Jack-SparrowQ/Teslaneitor/electronics/bom.csv

componente | cantidad | estado | funcion | coste_aprox_usd | certeza | notas
Arduino Uno R3 CH340 | 1 | incluido | control y maquina de estados | 0 | KIT | alimentado por VIN desde la bateria (H3)
Controlador L298N | 1 | incluido | driver de motores | 0 | KIT | anadir pull-down 10k en ENA/ENB; datasheet B8 pendiente
Motorreductor 1:48 doble eje | 2 | incluido | traccion | 0 | KIT | tension y rpm sin verificar (T2)
Rueda 65x25 mm | 2 | incluido | traccion | 0 | KIT
Rueda loca | 1 | incluido | apoyo | 0 | KIT
Sensor ultrasonico HC-SR04 | 1 | incluido | distancia frontal | 0 | KIT | objeto >= 0.5 m2 (B5)
Sensor TCRT5000 | 2 | incluido | no usado en v1 | 0 | KIT
Modulo Bluetooth HC-06/BT-04 | 1 | incluido | no usado en v1 | 0 | KIT
Chasis acrilico + tornilleria | 1 | incluido | estructura | 0 | KIT | pala de sumo desmontada
Portapilas 6xAA | 1 | incluido | alimentacion | 0 | KIT
ESP32-CAM AI-Thinker (OV2640) | 1 | propuesto | foto + SD + NTP + log | 6-10 | VERIFICAR
Programador ESP32-CAM-MB (USB) | 1 | propuesto | programar ESP32-CAM | 3-5 | VERIFICAR | a veces viene junto con la ESP32-CAM
Tarjeta microSD 4-8 GB FAT32 | 1 | propuesto | fotos y log | 4-8 | VERIFICAR | especificacion: max 4 GB (B6; H5)
Adaptador de nivel bidireccional BSS138 4 canales | 1 | propuesto | UART 5V <-> 3.3V | 1-2 | VERIFICAR | sustituye al divisor (H1)
Convertidor buck a 5 V (p. ej. MP1584) | 1 | propuesto | alimentacion ESP32-CAM | 1-3 | VERIFICAR | ajustar a 5.0 V con multimetro antes de conectar
Condensador electrolitico 470 uF 16 V | 1 | propuesto | desacoplo ESP32-CAM | 0.2 | VERIFICAR
Condensador ceramico 100 nF | 3 | propuesto | desacoplo y filtro A0 | 0.1 | VERIFICAR
Resistencias 10k (x2) y 100k (x1) | 1 surtido | propuesto | pull-down ENA/ENB y divisor de bateria | 1-3 | VERIFICAR
Pulsador | 1 | propuesto | boton de inicio / rearme | 0.2 | VERIFICAR
Interruptor de palanca | 1 | propuesto | parada de emergencia | 0.5-1 | VERIFICAR | solo si el kit no trae
Pilas AA NiMH + cargador | 6 | propuesto | alimentacion | 10-20 | VERIFICAR | solo si no las tienes
