Jack-SparrowQ/Teslaneitor/electronics/kicad/teslaneitor.pdf

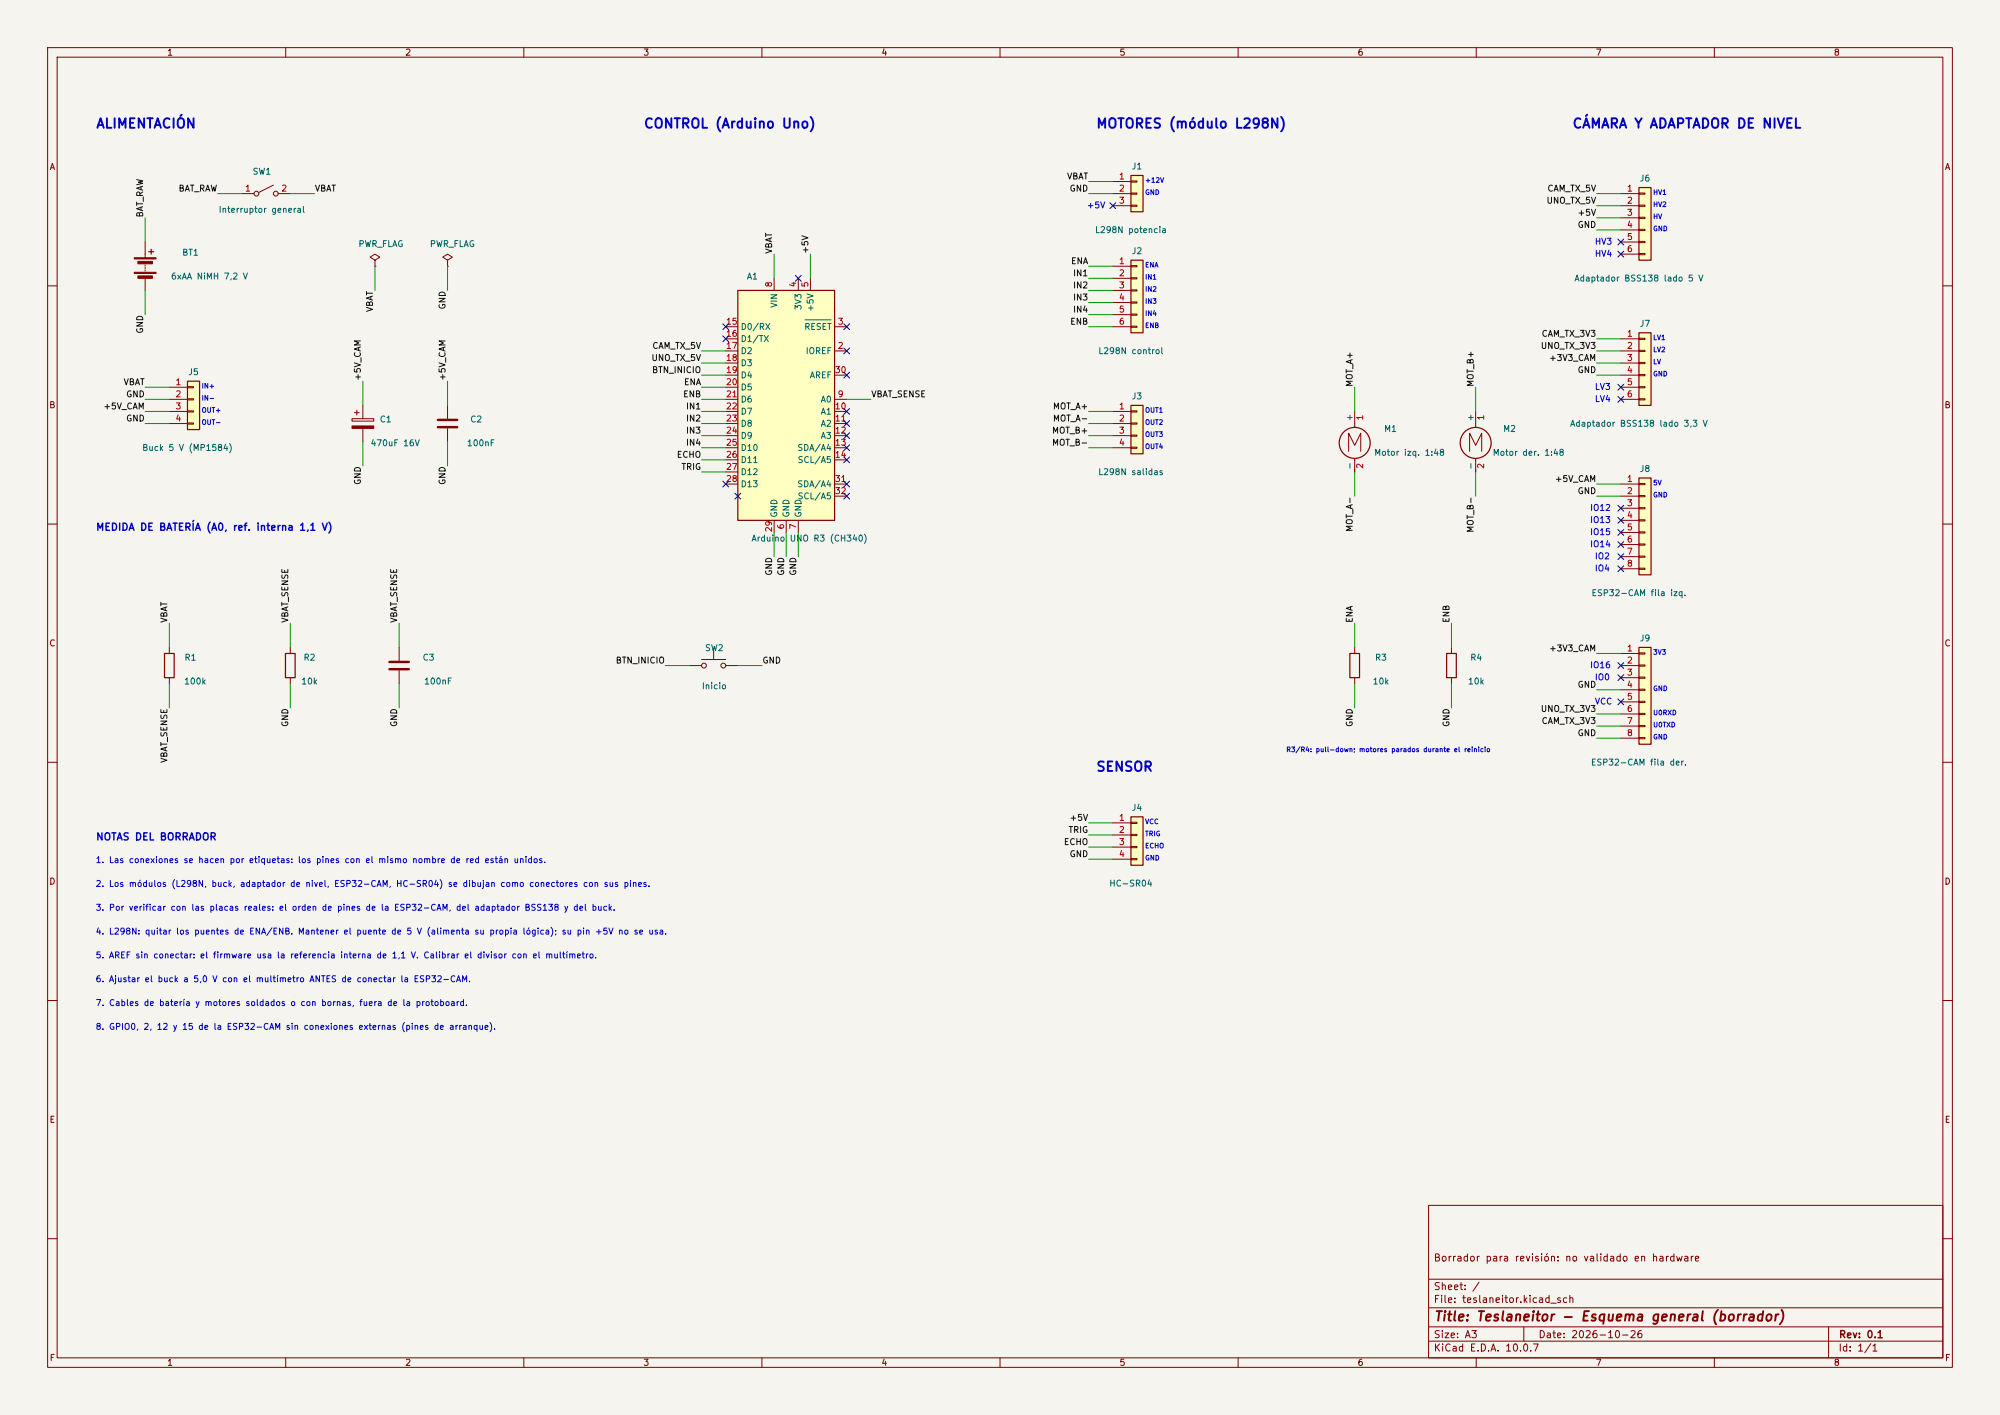
[picture p3: page 1]

GND CÁMARA Y ADAPTADOR DE NIVEL

1. Las conexiones se hacen por etiquetas: los pines con el mismo nombre de red están unidos. 6. Ajustar el buck a 5,0 V con el multímetro ANTES de conectar la ESP32-CAM.

7. Cables de batería y motores soldados o con bornas, fuera de la protoboard. 2. Los módulos (L298N, buck, adaptador de nivel, ESP32-CAM, HC-SR04) se dibujan como conectores con sus pines.

4. L298N: quitar los puentes de ENA/ENB. Mantener el puente de 5 V (alimenta su propia lógica); su pin +5V no se usa.

Borrador para revisión: no validado en hardware

Sheet: /
File: teslaneitor.kicad_sch
Title: Teslaneitor - Esquema general (borrador)

Size: A3 | Rev: 0.1 | F Date: 2026-10-26
KiCad E.D.A. 10.0.7 | Id: 1/1
