Jack-SparrowQ/Teslaneitor/electronics/kicad/teslaneitor.kicad_sch

## KiCad design electronics/kicad/teslaneitor.kicad_sch (2026-10-27)

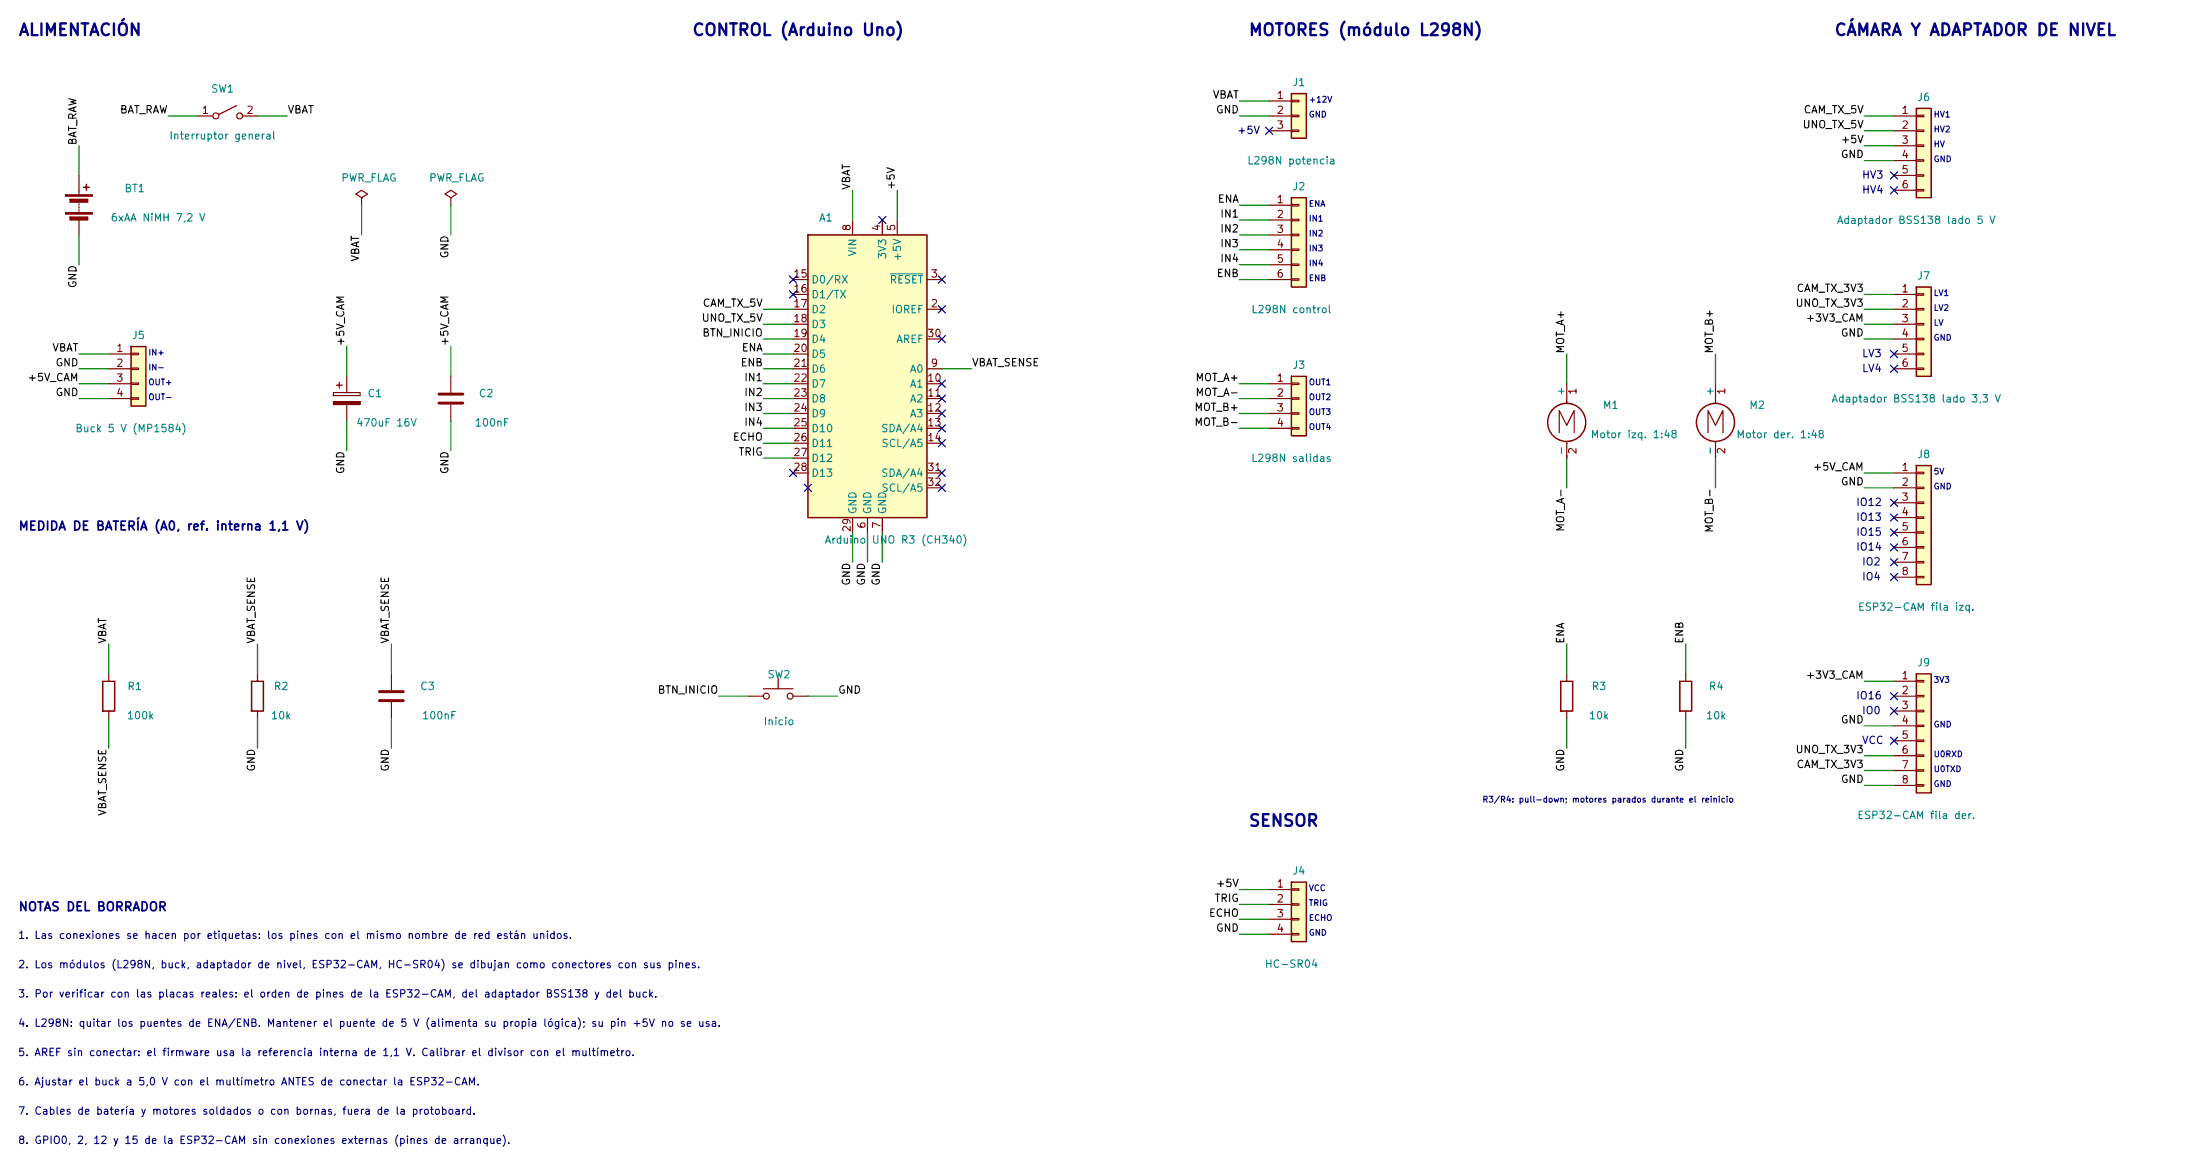
[picture p4: schematic teslaneitor.kicad_sch]

Parts:
A1: Arduino UNO R3 (CH340)
BT1: 6xAA NiMH 7,2 V
C1: 470uF 16V
C2, C3: 100nF
J1: L298N potencia
J2: L298N control
J3: L298N salidas
J4: HC-SR04
J5: Buck 5 V (MP1584)
J6: Adaptador BSS138 lado 5 V
J7: Adaptador BSS138 lado 3,3 V
J8: ESP32-CAM fila izq.
J9: ESP32-CAM fila der.
M1: Motor izq. 1:48
M2: Motor der. 1:48
R1: 100k
R2, R3, R4: 10k
SW1: Interruptor general
SW2: Inicio

Connections:
+3V3_CAM: J7.3, J9.1
+5V: A1.5 (+5V), J4.1, J6.3
+5V_CAM: C1.1, C2.1, J5.3, J8.1
BAT_RAW: BT1.1 (+), SW1.1 (A)
BTN_INICIO: A1.19 (D4), SW2.1
CAM_TX_3V3: J7.1, J9.7
CAM_TX_5V: A1.17 (D2), J6.1
ECHO: A1.26 (D11), J4.3
ENA: A1.20 (D5), J2.1, R3.1
ENB: A1.21 (D6), J2.6, R4.1
GND: A1.6 (GND), A1.7 (GND), A1.29 (GND), BT1.2 (-), C1.2, C2.2, C3.2, J1.2, J4.4, J5.2, J5.4, J6.4, J7.4, J8.2, J9.4, J9.8, R2.2, R3.2, R4.2, SW2.2
IN1: A1.22 (D7), J2.2
IN2: A1.23 (D8), J2.3
IN3: A1.24 (D9), J2.4
IN4: A1.25 (D10), J2.5
MOT_A+: J3.1, M1.1 (+)
MOT_A-: J3.2, M1.2 (-)
MOT_B+: J3.3, M2.1 (+)
MOT_B-: J3.4, M2.2 (-)
TRIG: A1.27 (D12), J4.2
UNO_TX_3V3: J7.2, J9.6
UNO_TX_5V: A1.18 (D3), J6.2
VBAT: A1.8 (VIN), J1.1, J5.1, R1.1, SW1.2 (B)
VBAT_SENSE: A1.9 (A0), C3.1, R1.2, R2.1

Notes on the sheet:
ALIMENTACIÓN
IN+
IN-
OUT+
OUT-
MEDIDA DE BATERÍA (A0, ref. interna 1,1 V)
CONTROL (Arduino Uno)
MOTORES (módulo L298N)
+5V
+12V
GND
ENA
IN1
IN2
IN3
IN4
ENB
OUT1
OUT2
OUT3
OUT4
R3/R4: pull-down; motores parados durante el reinicio
SENSOR
VCC
TRIG
ECHO
CÁMARA Y ADAPTADOR DE NIVEL
HV3
HV4
HV1
HV2
LV3
LV4
LV1
LV2
IO12
IO13
IO15
IO14
IO2
IO4
IO16
IO0
3V3
U0RXD
U0TXD
NOTAS DEL BORRADOR
1. Las conexiones se hacen por etiquetas: los pines con el mismo nombre de red están unidos.
2. Los módulos (L298N, buck, adaptador de nivel, ESP32-CAM, HC-SR04) se dibujan como conectores con sus pines.
3. Por verificar con las placas reales: el orden de pines de la ESP32-CAM, del adaptador BSS138 y del buck.
4. L298N: quitar los puentes de ENA/ENB. Mantener el puente de 5 V (alimenta su propia lógica); su pin +5V no se usa.
5. AREF sin conectar: el firmware usa la referencia interna de 1,1 V. Calibrar el divisor con el multímetro.
6. Ajustar el buck a 5,0 V con el multímetro ANTES de conectar la ESP32-CAM.
7. Cables de batería y motores soldados o con bornas, fuera de la protoboard.
8. GPIO0, 2, 12 y 15 de la ESP32-CAM sin conexiones externas (pines de arranque).
