Jack-SparrowQ/Teslaneitor/(commit log)

2026-10-26 Add phase 0-1 proposal, kit integration plan and initial BOM
    - docs/fase-0-propuesta.md: scope, requirements, alternatives, risks, phase plan
    - docs/fase-1-integracion-kit.md: Arduino Uno kit + ESP32-CAM integration (D-04..D-08)
    - electronics/bom.csv: included vs proposed components
    [bom.csv]
2026-10-26 Add phase 2 spec verification and phase 3 architecture
    - docs/fase-2-especificaciones.md: datasheet-verified specs, findings H1-H6
    - docs/fase-3-arquitectura.md: pin map, UART protocol, log format, state machine, fault analysis
    - references/bibliography.md: primary/secondary sources B1-B11
    - Update phase 0/1 docs, risks R-13..R-15 and BOM (level shifter, microSD, resistors)
    [bom.csv]
2026-10-27 Add KiCad schematic draft, design report and phase 3 approvals
    - electronics/kicad: schematic draft v0.1 (ERC clean), project file and PDF export
    - docs/fase-5-esquema.md: schematic description and verification
    - docs/fase-3-arquitectura.md: record decisions D-09..D-12
    - docs/entregables: preliminary design report (.docx)
    - .gitignore: KiCad local and backup files
    [teslaneitor.kicad_sch]
